mbouyer/canbus_solar_mppt/hardware/CAD/decoupe-couvercle.dxf

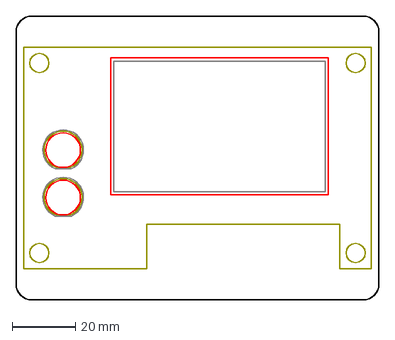
[picture p1: CAD file, 2023-04-26]
hardware/CAD/decoupe-couvercle.dxf
114.7 x 89.7 mm
