mbouyer/canbus_solar_mppt/hardware/CAD/pcb-stack.dxf

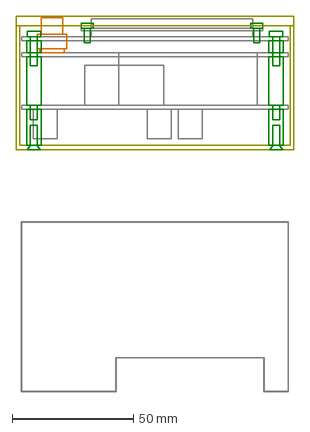
[picture p2: CAD file, 2023-01-29]
hardware/CAD/pcb-stack.dxf
114.7 x 154.9 mm
