mbouyer/canbus_solar_mppt/hardware/CAD/control-Edge_Cuts.dxf

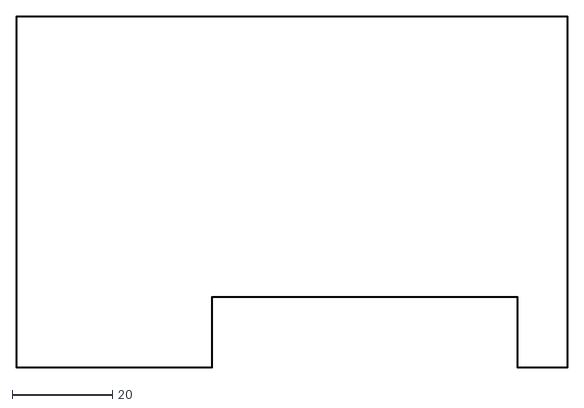
[picture p3: CAD file, 2023-01-26]
hardware/CAD/control-Edge_Cuts.dxf
110.1 x 70.1
