mbouyer/canbus_solar_mppt/software/pic18_mppt/i2c.c

/*
 * Copyright (c) 2022 Manuel Bouyer
 *
 * All rights reserved.
 *
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
 * THIS SOFTWARE IS PROVIDED BY THE NETBSD FOUNDATION, INC. AND CONTRIBUTORS
 * ``AS IS'' AND ANY EXPRESS OR IMPLIED WARRANTIES, INCLUDING, BUT NOT LIMITED
 * TO, THE IMPLIED WARRANTIES OF MERCHANTABILITY AND FITNESS FOR A PARTICULAR
 * PURPOSE ARE DISCLAIMED.  IN NO EVENT SHALL THE FOUNDATION OR CONTRIBUTORS
 * BE LIABLE FOR ANY DIRECT, INDIRECT, INCIDENTAL, SPECIAL, EXEMPLARY, OR
 * CONSEQUENTIAL DAMAGES (INCLUDING, BUT NOT LIMITED TO, PROCUREMENT OF
 * SUBSTITUTE GOODS OR SERVICES; LOSS OF USE, DATA, OR PROFITS; OR BUSINESS
 * INTERRUPTION) HOWEVER CAUSED AND ON ANY THEORY OF LIABILITY, WHETHER IN
 * CONTRACT, STRICT LIABILITY, OR TORT (INCLUDING NEGLIGENCE OR OTHERWISE)
 * ARISING IN ANY WAY OUT OF THE USE OF THIS SOFTWARE, EVEN IF ADVISED OF THE
 * POSSIBILITY OF SUCH DAMAGE.
 */

#include <xc.h>
#include <stdio.h>
#include <stdlib.h>
#include <i2c.h>

#if 1
#define DPRINTF(x) printf x
#else
#define DPRINTF(x) /**/
#endif

typedef volatile enum {
	I2C_IDLE = 0,
	I2C_TX,
	I2C_RX_TXREG,
	I2C_RX,
	I2C_TXDMA,
	I2C_RXDMA,
} i2c_status_t;

static i2c_status_t i2c_status;
static i2c_return_t *i2c_return;
static uint8_t i2c_address;
static uint8_t *i2c_data;
static uint8_t i2c_size;
static __bit i2c_swap;

static void i2c_printstatus(void);

#define I2C_IRQDIS \
	{ \
		I2C1ERRbits.NACKIE = 0; \
		I2C1PIEbits.CNTIE = 0; \
		PIE7bits.I2C1TXIE = 0; \
		PIE7bits.I2C1RXIE = 0; \
		PIE7bits.I2C1IE = 0; \
		PIE7bits.I2C1EIE = 0; \
	}

#define I2C_IRQEN \
	{ \
		I2C1ERRbits.NACKIE = 1; \
		I2C1PIEbits.CNTIE = 1; \
		PIE7bits.I2C1IE = 1; \
		PIE7bits.I2C1EIE = 1; \
	}

#define I2C_WAIT_TX { \
	int i2c_wait_count = 0; \
	while (!I2C1STAT1bits.TXBE) { \
		i2c_wait_count++; \
		if (i2c_wait_count == 30000) { \
			printf("I2C@%d TX timeout\n", (int)address); \
			i2c_printstatus(); \
			i2c_wait_idle(); \
			*r = I2C_ERROR; \
			return; \
		} \
	} \
    }

static inline uint8_t
i2c_wait_idle(void)
{
	int i2c_wait_count = 0;
	uint8_t tries = 0;
	while (I2C1STAT0bits.MMA) {
		i2c_wait_count++;
		if (i2c_wait_count == 10000) {
			if (tries > 0 || I2C1CON1bits.P) {
				printf(("I2C idle timeout\n"));
				i2c_printstatus();
				return 0;
			}
			I2C1CON1bits.P = 1;
			tries++;
			i2c_wait_count = 0;
		}
	}
	return 1;
}

static void
i2c_readreg_s(const uint8_t address, uint8_t reg, uint8_t *data, uint8_t size, uint8_t swap, i2c_return_t *r)
{
	*data = 0;
	uint8_t i;
	uint16_t i2c_wait_count;
	int retry_count = 5;

again:
	if (retry_count-- == 0) {
		printf("i2c read: retry == 0 ");
		i2c_printstatus();
		*r= I2C_ERROR;
		return;
	}
	if (i2c_wait_idle() == 0) {
		*r= I2C_ERROR;
		return;
	}
	*r= I2C_INPROGRESS;

	I2C1STAT1bits.CLRBF = 1;
	I2C1STAT1 = 0;
	I2C1PIR = 0;
	I2C1ERR = 0;

	/* send register address */
	I2C1CON0bits.RSEN = 1;
	I2C1CON1bits.ACKDT = 0;
	I2C1CON1bits.ACKCNT = 0;
	I2C1ADB1 = address;
	I2C1CNTH = 0;
	I2C1CNTL = 1;
	I2C1TXB = reg;
	I2C1CON0bits.S = 1;
	i2c_status = I2C_RX_TXREG;

	if (swap) {
		i2c_data = &data[size - 1];
		i2c_swap = 1;
	} else {
		i2c_data = &data[0];
		i2c_swap = 0;
	}
	i2c_address = address;
	i2c_size = size;
	i2c_return = r;

	I2C_IRQEN;

	return;
#if 0


	I2C_WAIT_TX;

	while (!I2C1CON0bits.MDR) {
		;
	}
	if (I2C1ERRbits.NACKIF) {
		printf("i2c_read NACK\n");
		goto again;
	}
	/* read bytes */
	I2C1PIR = 0;
	I2C1ERR = 0;
	I2C1CON0bits.RSEN = 0;
	I2C1CON1bits.ACKCNT = 1;
	I2C1CON1bits.ACKDT = 0;
	I2C1ADB1 = address | 1;
	I2C1CNTH = 0;
	I2C1CNTL = size;
	I2C1CON0bits.S = 1;
	if (swap) {
		i2c_data = &data[size - 1];
		i2c_swap = 1;
	} else {
		i2c_data = &data[0];
		i2c_swap = 0;
	}
	i2c_status = I2C_RX;
	i2c_return = r;
	I2C_IRQEN;
	PIE7bits.I2C1RXIE = 1;
#endif

#if 0
	for (i = size ; i != 0; i--) {
		for (i2c_wait_count = 10000; i2c_wait_count > 0; i2c_wait_count--) {
			if (I2C1STAT1bits.RXBF)
				break;
		}
		if (i2c_wait_count == 0) {
			printf("I2C RX timeout: ");
			i2c_printstatus();
			I2C1STAT1 = 0;
			I2C1ERR = 0;
			goto again;
		}
		if (swap) {
			data[i - 1] = I2C1RXB;
		} else {
			data[size - i] = I2C1RXB;
		}
	}
	*r= I2C_COMPLETE;
#endif
}

void
i2c_readreg(const uint8_t address, uint8_t reg, uint8_t *data, uint8_t size,
    i2c_return_t *r) {
	i2c_readreg_s(address, reg, data, size, 0, r);
}

void
i2c_readreg_be(const uint8_t address, uint8_t reg, uint8_t *data, uint8_t size,
    i2c_return_t *r) {
	return i2c_readreg_s(address, reg, data, size, 1, r);
}

static void
i2c_writereg_s(const uint8_t address, uint8_t reg, uint8_t *data, uint8_t size,
    uint8_t swap, i2c_return_t *r)
{
	uint8_t i;


	if (i2c_wait_idle() == 0) {
		*r = I2C_ERROR;
		return;
	}

	*r = I2C_INPROGRESS;
	i2c_address = address;

	I2C1STAT1bits.CLRBF = 1;
	I2C1STAT1 = 0;
	I2C1PIR = 0;
	I2C1ERR = 0;

	/* send register address */
	I2C1CON0bits.RSEN = 0;
	I2C1CON1bits.ACKDT = 0;
	I2C1CON1bits.ACKCNT = 1;
	I2C1ADB1 = address;
	I2C1CNTH = 0;
	I2C1CNTL = size + 1;
	I2C1TXB = reg;
	I2C1CON0bits.S = 1;
	if (swap) {
		i2c_data = &data[size - 1];
		i2c_swap = 1;
	} else {
		i2c_data = &data[0];
		i2c_swap = 0;
	}
	i2c_status = I2C_TX;
	i2c_return = r;
	I2C_IRQEN;
	PIE7bits.I2C1TXIE = 1;
}

void
i2c_writereg(const uint8_t address, uint8_t reg, uint8_t *data, uint8_t size,
    i2c_return_t *r)
{
	i2c_writereg_s(address, reg, data, size, 0, r);
}

void
i2c_writereg_be(const uint8_t address, uint8_t reg, uint8_t *data, uint8_t size,
    i2c_return_t *r)
{
	i2c_writereg_s(address, reg, data, size, 1, r);
}

void
i2c_writecmd(const uint8_t address, uint8_t reg, i2c_return_t *r)
{
	i2c_writereg(address, reg, NULL, 0, r);
}                                     

void
i2c_writereg_dma(const uint8_t address, uint8_t reg, uint8_t *data,
    uint16_t size, i2c_return_t *r)
{
	uint8_t i;

	if (i2c_wait_idle() == 0) {
		*r = I2C_ERROR;
		return;
	}

	*r = I2C_INPROGRESS;
	i2c_address = address;
	I2C1STAT1bits.CLRBF = 1;
	I2C1STAT1 = 0;
	I2C1PIR = 0;
	I2C1ERR = 0;
	PIR2 &= 0x0f;

	/* send register address */
	I2C1CON0bits.RSEN = 0;
	I2C1CON1bits.ACKDT = 0;
	I2C1CON1bits.ACKCNT = 1;
	I2C1ADB1 = address;
	I2C1CNTH = (size + 1) >> 8;
	I2C1CNTL = (size + 1) & 0xff;
	I2C1TXB = reg;
	I2C1CON0bits.S = 1;
	/* setup DMA1 */
	DMASELECT = 0;
	DMAnCON0 = 0;
	DMAnCON1 = 0x03; /* SSTP, source increment, source from RAM */
	DMAnSSAL = ((uint16_t)data) & 0xff;
	DMAnSSAH = ((uint16_t)data) >> 8;
	DMAnSSAU = 0;
	DMAnSSZH = (size >> 8);
	DMAnSSZL = size & 0xff;
	DMAnDSA = &I2C1TXB;
	DMAnDSZL = 1;
	DMAnDSZH = 0;
	DMAnSIRQ = 0x39; /* I2C1TX */
	DMAnAIRQ = 0x3b; /* I2C1E */
	DMAnAIRQ = 0;

	DMAnCON0 = 0xc4; /* enable, hardware IRQ trigger/abort */

	i2c_status = I2C_TXDMA;
	i2c_return = r;
	I2C_IRQEN;

#if 0
	i = i2c_wait(i2c_return);
	if (*i2c_return != I2C_COMPLETE || PIR2bits.DMA1AIF) {
		printf(" %d I2C@%d TX DMA timeout\n", *r, (int)address);
		printf("SCNT %d CON0 0x%x PIR2 0x%x\n", (int)DMAnSCNT, (int)DMAnCON0, (int)PIR2);
		i2c_printstatus();
	}
#endif
	return;
}

void __interrupt(__irq(I2C1TX), __low_priority, base(IVECT_BASE))
irql_i2c1tx(void)
{
	I2C1TXB = *i2c_data;
	if (i2c_swap)
		i2c_data--;
	else
		i2c_data++;
}

void __interrupt(__irq(I2C1RX), __low_priority, base(IVECT_BASE))
irql_i2c1rx(void)
{
	*i2c_data = I2C1RXB;
	if (i2c_swap)
		i2c_data--;
	else
		i2c_data++;
}

void __interrupt(__irq(I2C1), __low_priority, base(IVECT_BASE))
irql_i2c1(void)
{
	if (I2C1PIRbits.CNTIF) {
		if (i2c_status == I2C_RX_TXREG) {
			if (!I2C1CON0bits.MDR) {
				I2C_IRQDIS;
				if (I2C1STAT0bits.MMA)
					I2C1CON1bits.P = 1;
				*i2c_return = I2C_ERROR;
				i2c_status = I2C_IDLE;
				return;
			}
			/* read bytes */
			I2C1PIR = 0;
			I2C1ERR = 0;
			I2C1CON0bits.RSEN = 0;
			I2C1CON1bits.ACKCNT = 1;
			I2C1CON1bits.ACKDT = 0;
			I2C1ADB1 = i2c_address | 1;
			I2C1CNTH = 0;
			I2C1CNTL = i2c_size;
			I2C1CON0bits.S = 1;
			i2c_status = I2C_RX;
			PIE7bits.I2C1RXIE = 1;
		} else {
			I2C_IRQDIS;
			*i2c_return = I2C_COMPLETE;
			i2c_status = I2C_IDLE;
		}
	}
}

void __interrupt(__irq(I2C1E), __low_priority, base(IVECT_BASE))
irql_i2c1error(void)
{
	if (I2C1ERRbits.NACKIF) {
		I2C_IRQDIS;
		if (I2C1STAT0bits.MMA)
			I2C1CON1bits.P = 1;
		*i2c_return = I2C_ERROR;
		i2c_status = I2C_IDLE;
	}
}

void
i2c_init(void)
{
	RC4I2C = 0x41; /* I2C fast slew-rate, no pull-up, i2c threshold */
	RC3I2C = 0x41; /* I2C fast slew-rate, no pull-up, i2c threshold */
	RC3PPS = 0x37; /* SCL */
	RC4PPS = 0x38; /* SDA */
	I2C1SCLPPS = 0x13; /* RC3 */
	I2C1SDAPPS = 0x14; /* RC4 */
	ODCONCbits.ODCC3 = 1;
	ODCONCbits.ODCC4 = 1;
	LATCbits.LATC3 = 1;
	LATCbits.LATC4 = 1;
	TRISCbits.TRISC3 = 0;
	TRISCbits.TRISC4 = 0;
	I2C1CON0 = 0x04; /* On, 7 bits I2C host mode */
	I2C1CON1 = 0;
	I2C1CON2 = 0x04; /* FME, address buffer enabled, 100ns SDA hold */
	I2C1CLK = 1; /* clock = fosc  (10000khz) */
	I2C1BAUD = 4; /* prescale = 5 -> clk = 500Khz */
	I2C1ERR = 0x01; /* enable NACK interrupt */
	I2C1CON0bits.EN = 1;

	i2c_status = I2C_IDLE;
}

void
i2c_abort()
{
	printf("I2C@%d abort %d\n", (int)i2c_address, i2c_status);
	i2c_printstatus();
	i2c_wait_idle();
	*i2c_return = I2C_ERROR;
}

static void
i2c_printstatus(void)
{
	printf("%d CON 0x%x 0x%x 0x%x", i2c_status, I2C1CON0, I2C1CON1, I2C1CON2);
	printf("  STAT 0x%x 0x%x PIR 0x%x", I2C1STAT0, I2C1STAT1, I2C1PIR);
	printf("  ERR 0x%x CNT 0x%x 0x%x\n", I2C1ERR, I2C1CNTH, I2C1CNTL);
}
