mbouyer/canbus_solar_mppt/(commit log)

2023-01-18 Work in progress: - copy pic18 + canbus from battery_monitor, as well as the voltage/current measure section - build the power supply circuit
    [canbus_solar_mppt.kicad_pcb, canbus_solar_mppt.kicad_sch, dc-dc.kicad_sch, logic_canbus.kicad_sch]
2023-01-18 Add feedthrough capacitors as EMI filters on power inputs
    [canbus_solar_mppt.kicad_sch, dc-dc.kicad_sch, logic_canbus.kicad_sch]
2023-01-19 WIP: complete DC/DC engine
    [canbus_solar_mppt.kicad_sch, dc-dc.kicad_sch]
2023-01-20 Add a voltage reference for the pic18 comparator, and a matching voltage divider at DC/DC output.
    [canbus_solar_mppt.kicad_sch, dc-dc.kicad_sch, logic_canbus.kicad_sch]
2023-01-20 Add more signals between pic18 and DC/DC
    [canbus_solar_mppt.kicad_sch, dc-dc.kicad_sch, logic_canbus.kicad_sch]
2023-01-20 Add MCOB12864JX oled display. I2C-connected, not enough pic18 pins for SPI ...
    [canbus_solar_mppt.kicad_sch, logic_canbus.kicad_sch]
2023-01-20 Add 2 control buttons (could be more).
    [canbus_solar_mppt.kicad_sch, logic_canbus.kicad_sch]
2023-01-20 Use a SMD thermistor
    [canbus_solar_mppt.kicad_sch, logic_canbus.kicad_sch]
2023-01-21 Add footprint for OLED display annotate schematic run and fix ERC
    [canbus_solar_mppt.kicad_sch, dc-dc.kicad_sch, logic_canbus.kicad_sch]
2023-01-21 Decrease pull gate resitors of P-MOS to decrease turn-off time. Maybe switch to a gate driver ic ?
    [canbus_solar_mppt.kicad_sch, dc-dc.kicad_sch]
2023-01-21 Fix up resistor footprints, use only SMD for now.
    [canbus_solar_mppt.kicad_sch, dc-dc.kicad_sch, logic_canbus.kicad_sch]
2023-01-21 Switch from BSS123 + GS resistor to DGD0215 mosfet driver.
    [canbus_solar_mppt.kicad_sch, dc-dc.kicad_sch, logic_canbus.kicad_sch]
2023-01-22 Change Pmos transistors for a reference with larger package. Ajust some other footprints.
    [canbus_solar_mppt.kicad_sch, dc-dc.kicad_sch]
2023-01-22 Really connect PAC1953 EP to GND
    [dc-dc.kicad_sch]
2023-01-22 Route de power part of the project
    [canbus_solar_mppt.kicad_pcb]
2023-01-22 Split project in 2 boards: the power DC/DC and associated instrumentation, and control (with pic18 and canbus)
    [canbus_solar_mppt.kicad_sch, control.kicad_pcb, control.kicad_sch, logic_canbus.kicad_sch, power-dcdc.kicad_pcb, power-dcdc.kicad_sch]
2023-01-22 Add board-to-board connectors.
    [power-dcdc.kicad_sch]
2023-01-22 Rsync PCB with schematic
    [power-dcdc.kicad_pcb]
2023-01-22 Finish routing the power board
    [power-dcdc.kicad_pcb, power-dcdc.kicad_sch]
2023-01-22 Make sure to remove isolated ground planes. Add more GND vias.
    [power-dcdc.kicad_pcb]
2023-01-23 Move thermistor to power-dcdc board (measure board temp) Adjust power-dcdc board layout, pass DRC
    [control.kicad_sch, power-dcdc.kicad_pcb, power-dcdc.kicad_sch]
2023-01-23 Add board-to-board connectors in control schematic
    [control.kicad_sch]
2023-01-23 Place holes and connectors on control board to match DC/DC
    [control.kicad_pcb]
2023-01-23 Make power tracks larger
    [power-dcdc.kicad_pcb]
2023-01-23 Route control board. Will need a separate board for display.
    [control.kicad_pcb, control.kicad_sch]
2023-01-24 Re-route PCBs to move RJ45 connectors on bottom, saving a bit of stack size.
    [control.kicad_pcb, control.kicad_sch, power-dcdc.kicad_pcb, power-dcdc.kicad_sch]
2023-01-25 Adjust PWM resistor divider to better match NCP5091B mid-state input voltage.
    [control.kicad_pcb, control.kicad_sch]
2023-01-25 WIP on diaplay PCB.
    [control.kicad_sch, display.kicad_pcb, display.kicad_sch]
2023-01-25 Route display PCB. Adjust control for connector wiring changes.
    [control.kicad_pcb, control.kicad_sch, display.kicad_pcb, display.kicad_sch]
2023-01-25 Finish routing control board
    [control.kicad_pcb]
2023-01-25 Cleanup trace & via of display board
    [display.kicad_pcb]
2023-01-25 optimise some more control board
    [control.kicad_pcb]
2023-01-25 optimise a bit power board
    [power-dcdc.kicad_pcb]
2023-01-26 Add PCB stack drawing
    [control-Edge_Cuts.dxf, pcb-stack.dxf]
2023-01-27 normalise and update P/N, update footprint to match
    [control.kicad_sch, display.kicad_sch, power-dcdc.kicad_sch]
2023-01-27 Adjust PCBs after reference and footprint changes
    [control.kicad_pcb, display.kicad_pcb, power-dcdc.kicad_pcb]
2023-01-27 Adjust track near connector
    [control.kicad_pcb]
2023-01-27 Route unused RA5 to display and power board connectors, "just in case"
    [control.kicad_pcb, control.kicad_sch]
2023-01-28 pcb-stack.dxf: add more details
    [pcb-stack.dxf]
2023-01-28 power-dcdc: move power connectors closer to edge, the connectors used are actually a bit smaller than footprint
    [power-dcdc.kicad_pcb]
2023-01-28 control: view the inductance from dcdc
    [control.kicad_pcb]
2023-01-29 Adjust for "0 height" display nuts
    [control.kicad_pcb, display.kicad_pcb]
2023-01-29 pcb-stack: add more defatils
    [pcb-stack.dxf]
2023-01-29 One more cosmetic track adjust
    [control.kicad_pcb]
2023-01-29 On second though, the pac1953 won't be fast enough for the PWM regulation loop. So add a resistor divider routed to RA5 to get the solar voltage from the PIC18's ADC.
    [control.kicad_pcb, control.kicad_sch, power-dcdc.kicad_pcb, power-dcdc.kicad_sch]
2023-01-29 Re-annotate schematics
    [control.kicad_pcb, control.kicad_sch, power-dcdc.kicad_pcb, power-dcdc.kicad_sch]
2023-01-29 Connect mounting holes to GND
    [control.kicad_pcb, control.kicad_sch, display.kicad_pcb, display.kicad_sch, power-dcdc.kicad_pcb, power-dcdc.kicad_sch]
2023-01-29 Change some resistor values to match available ones.
    [control.kicad_pcb, control.kicad_sch, power-dcdc.kicad_pcb, power-dcdc.kicad_sch]
2023-01-29 Final pass on part numbers
    [control.kicad_sch, display.kicad_sch, power-dcdc.kicad_sch]
2023-01-29 One more P/N update
    [power-dcdc.kicad_sch]
2023-02-03 Add a pulldown resistor to /RST_DISP
    [display.kicad_pcb, display.kicad_sch]
2023-02-12 one more track cleanup
    [power-dcdc.kicad_pcb]
2023-02-12 power-dcdc: increase clearance where possible; cleanup tracks
    [power-dcdc.kicad_pcb]
2023-02-12 power-dcdc: more track adjusteemnts
    [power-dcdc.kicad_pcb]
2023-02-12 control: rework tracks, increase clearance where possible.
    [control.kicad_pcb]
2023-02-12 *: connect unused connectors pins to GND
    [control.kicad_pcb, control.kicad_sch, display.kicad_pcb, display.kicad_sch, power-dcdc.kicad_pcb, power-dcdc.kicad_sch]
2023-02-22 Increase clearance once again
    [control.kicad_pcb, display.kicad_pcb, power-dcdc.kicad_pcb]
2023-03-01 Add some copper around J3's holes, so that they will get isolated
    [control.kicad_pcb]
2023-03-01 Add fabrication files
    [power-dcdc.kicad_pcb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]
2023-03-01 Add fab files for display
    [display.kicad_pcb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]
2023-03-03 regen fab files
    [control-B_Cu.gbr, control-F_Cu.gbr]
2023-03-06 Add solder mask/paste files
2023-03-12 Start writing pic18 software. Based on the battery_monitor soft.
2023-03-12 More efficient OLED_CTRL process: write multiple command bytes in one i2c transaction.
2023-03-12 Increase i2c frequency to 200Khz. Although the display works at 400Khz, it seems that the pac1953 works only up to 266Khz. To be investigated.
2023-03-12 implement DMA-based i2c writes. Still doing busy-wait for now ...
2023-03-12 Prefer extosc for i2c clock source.
2023-03-12 Use i2c errors to abort DMA1.
    [i2c.c]
2023-03-12 Add fonts from the canbus_autopilot project. Finally print a string on the oled
2023-03-13 i2c: be more robust against NACK on address byte.
2023-03-13 i2c: update API for upcoming interrupt mode.
2023-03-13 i2c: Use interrupts for write and write_dma
2023-03-15 Implement buttons: use comparator to get interrupts and ADC to get the button's value. Start using ADC contexts
2023-03-25 Tests have shown that the DGD0215 behavior when driven while not powered is quite bad: not only the drive voltage is forwarded to its Vcc pin (this is expexted), but when the voltage rises on Vcc thi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
    [power-dcdc.kicad_sch]
2023-03-25 power-dcdc: testings have shown that the NCP5901 zero cross detection trips way too early, leaving most of the low side current trough the body diode of the mosfet. It starts working properly at 3A. 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
    [power-dcdc.kicad_sch]
2023-03-25 Re-anotate schematic (from scratch)
    [power-dcdc.kicad_sch]
2023-03-26 Switch to a 60V N-channel mosfet on input, to have some margin.
    [power-dcdc.kicad_sch]
2023-03-26 Provision for a second bootstrap capacitor
    [power-dcdc.kicad_sch]
2023-03-26 On second through use a 1µF capacitor for bootstrap
    [power-dcdc.kicad_sch]
2023-03-26 Provision components to limit ringing on the sw node: A Rboot resistor and a R/C filter on the sw node.
    [power-dcdc.kicad_sch]
2023-03-26 Add a SMBJ16 on output of the dc/dc converter, usefull if the output mosfets are all off.
    [power-dcdc.kicad_sch]
2023-03-26 Make it clear that some components are not known yet.
    [power-dcdc.kicad_sch]
2023-03-26 Provision a schottky diode in parallel with Rboost
    [power-dcdc.kicad_sch]
2023-03-26 Annontate schematic again
    [power-dcdc.kicad_sch]
2023-03-26 Import schematic changes to PCB; re-route the output path.
    [power-dcdc.kicad_pcb]
2023-03-26 PCB: Add the TVS diode at the output of the DC/DC
    [power-dcdc.kicad_pcb]
2023-03-26 dcdc PCB: work in progress on switch node. Needs to move input capacitor to the right side of the solar power track; current loop through mosfets is way too long as it is !
    [power-dcdc.kicad_pcb]
2023-03-27 Finish re-implementing the SW node. Enlarge ground vias.
    [power-dcdc.kicad_pcb]
2023-03-27 Protect NCP5901 SW entry with a SMBJ28
    [power-dcdc.kicad_pcb, power-dcdc.kicad_sch]
2023-03-27 Cleanup tracks & via; run DRC
    [power-dcdc.kicad_pcb]
2023-03-27 Forgot to save schematic from previous
    [power-dcdc.kicad_sch]
2023-03-28 remplace lp4951 with the pin-compatible, more resistant mic2951. Add a 1µF at the input of the mic2951.
    [power-dcdc.kicad_pcb, power-dcdc.kicad_sch]
2023-03-28 Re-route around DCDC-PWM connector to get SOLAR_PWR from a place less subject to spikes
    [power-dcdc.kicad_pcb, power-dcdc.kicad_sch]
2023-03-28 Enlarge via holes from 0.6 to 0.7 (rivets don't fit in 0.6)
    [power-dcdc.kicad_pcb]
2023-03-28 Minor layout adjustements
    [power-dcdc.kicad_pcb]
2023-03-28 More minor adjustements
    [power-dcdc.kicad_pcb]
2023-03-28 Move PWM_OFF away from the strongest inductive (the SW node)
    [power-dcdc.kicad_pcb]
2023-03-28 Misc small cleanups
    [power-dcdc.kicad_pcb]
2023-03-28 Bump outer size of small vias to 1.7 to respect DRC. Run cleanup net & via and DRC.
    [power-dcdc.kicad_pcb]
2023-03-30 Fab files for dcdc V2
    [power-dcdc.kicad_pcb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]
2023-04-01 Fix convertion of xbm to our per-column format
    [icons16x16.c, xbm2font.c]
2023-04-01 Avoid race in button handling; process down event only when in idle state, report up even only once down event has been handled
    [main.c]
2023-04-01 No need to wait for address to be accepted before starting DMA
2023-04-01 i2c: use interrupts for read
2023-04-01 Make I2C_DATABUFSZ 256 bytes (2 full lines) and switch i2c_writereg_dma()'s len parameter to uint16_t
2023-04-01 Make OLED i2c operations event-driven
2023-04-02 Make i2c_read use interrupt for the reg write to data read transistion. Introduce i2c_abort(), to be used when a i2c transaction has to be stopped (e.g. timeout).
2023-04-02 Insert a blank column between characters for font 5x8 (making it really 6x8)
2023-04-02 Add and use shortcuts for unsigned {char,int,long}
    [main.c]
2023-04-02 Make PAC i2c operations event-driven
2023-04-02 Deal with i2c_return in *_i2c_exec()
2023-04-02 schedule i2c bus access in the main loop, giving priority to the PAC
2023-04-02 Fix bit ordering of pac_ctrl_t Was working because all important bits were 0
    [pac195x.h]
2023-04-02 Add a COMPLETE state to i2c state machine, to let users have a chance to known when a command has completed. Start periodic reading of PAC1953 values
2023-04-02 Fix pac_neg_pwr_fsr_t field order.
    [pac195x.h]
2023-04-02 switch voltages to PAC_PWRSFR_UFSR, so we can get values up to 32V
2023-04-07 Power: remove the DGD0215, they are still problematic (the Pmos are briefly on while power up, and can eventually stay on). Instead drive the Pmos gates directly from the BSS123, at the price of a lo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
    [power-dcdc.kicad_sch]
2023-04-13 Work in progress on driving BATT1/BATT2. Not there yet; the CLC seems OK but in looks like RB4/RB5 are stuck to some alternate function. Avoid undefined behavior when OLED is in error. Others minor c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
    [main.c]
2023-04-15 Implement reading the 4 ADC channels.
2023-04-16 Switch to CM2 for buttons interrupts; use CM1 for PVM_V monitoring.
2023-04-16 WIP on the PWM
2023-04-16 Remove SLEEP() from the main loop; it doens't affect power much, and makes short waits easier.
    [main.c]
2023-04-16 PWM is working, with static values for now
2023-04-16 Make error handling (PWM_OK down, PWM_OK timeout, PWM_V too high) work.
    [main.c]
2023-04-18 Implement PWM computation from duty cycle. Allow to ramp up duty cycle, to avoid PWM error at startup.
    [main.c]
2023-04-18 record batteries current with the correct sign
    [main.c]
2023-04-18 Introduce a chrg_fsm to drive the PWM
2023-04-18 Increase TU16A rate to 100hz. try to read the PAC average registers every 10ms. Update display at 5hz.
2023-04-19 Use raw current values for MPPT computations, and average on 4 samples. One-bit error from measure to measure would lead to large jumps of the duty cycle.
    [main.c]
2023-04-19 Add resistors on pic18 pads connected to DCDC-PWM connector; to protect from spike and accidental short-circuits with solar_power.
    [control.kicad_pcb, control.kicad_sch]
2023-04-20 On second though use 4K7 resistors on PIC18 I/O instead of 1K Update fabrication files.
    [control.kicad_pcb, control.kicad_sch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]
2023-04-20 Try to move faster when we're far away from the MP point. Implement constant voltage mode.
2023-04-20 Switch faster between CV and MPPT modes if the difference between bvolt and target is more than 0.5v
2023-04-22 Cleanup time handling; introduce a time_events bit structure which is reset on each loop. Makes it easier to handle time events in subroutines of main loop.
    [main.c]
2023-04-23 Implement main display page with large characters. Move actual display to debug page. Implement page switching.
2023-04-24 Ajust solder mask by -0.075mm for our fabrication process.
    [control.kicad_pcb]
2023-04-26 Add cover drawing, for machining buttons & display holes
    [decoupe-couvercle.dxf]
2023-04-26 With the updated control board, the transition from temnp to pwm_v on the ADC channel can discharge the ADC capacitor through the added 4.7k resistor and generate a spike which triggers the comparato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
    [main.c]
2023-04-28 Rework charger rampup&mppt: use the rampup results to locate the MP point.
    [main.c]
2023-04-28 In case of pwm error, wait one second and restart
    [main.c]
2023-04-28 check temperature once per second, and implement PWME_OVERTEMP error state. Temperature limit 70degC, restart at 60degC
    [main.c]
2023-04-28 Fix integer overflow in previous
    [main.c]
2023-04-28 WIP on battery scheduling: move some CHRG parameters to batt_context_t
2023-04-28 Mark batteries with more than 8V as active
2023-04-28 Fix mistake in _read_voltcur[] access. While there fix some numering mistakes in comments
    [main.c]
2023-04-28 Implement battery switching in the CHRG FSM.
2023-04-29 Stop CHRG (and so turn off batteries) when the current through the active battery goes backward. This avoids current going back to solar power rail, with the charger staying on.
    [main.c]
2023-04-29 CHRG_BSWITCH: if we didn't switch batteries go back to previous state
    [main.c]
2023-04-29 Implement basic battery scheduling: - record in battery context the time at which the battery became active - when switching to a battery in CV mode, ignore mode change for the 4 first PAC values, to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
2023-04-29 RAMPUP: check battery voltage only if bvalues_updated is true
2023-04-29 Autostart charger when conditions are good. Remove debug handling from buttons
2023-04-29 Average values over 1s using a sliding buffer for display. This gives more stable values with battery scheduling
2023-04-29 Improve recovery when one batterie dissapear: - reset battery states on negative battery current - increase error recovery time to 2s - don't check batterie presence while the PWM is in error state (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
    [main.c]
2023-04-30 Rework battery states: Remove CC, CV and CV_FLOAT and add BATTS_STANDBY, BATTS_BULK and BATTS_FLOAT. standby if for when we start with the voltage above 80% SOC, we consider there's no need to charge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
    Add batt_params_t to store various voltage states
    factor out some state checks in functions
    Decrease some timings so they have a chance to work with battery scheduling
    On negative current, reset state of active battery only.
    [main.c]
2023-04-30 Display batteries state in debug page Remove printf() in battery switch.
2023-04-30 Use local variable to avoid repetitive batt_v[] / 10
    [main.c]
2023-04-30 battstat2buf_*: don't print intensity if battery is not charging
2023-04-30 Add a details display page, with N2K addr, board temperature and battery status
2023-04-30 battstat2buf_*: work around a bug with sprintf("%2.1f") in a better way. One decimal for temperature is enough
    [main.c]
2023-04-30 Add some smoothing to temperature output from adc.
2023-04-30 Rerun a rampup for a battery if: - there has been 10mn since the last rampup - the duty cycle changed more than 10% - the current changed more than 10%
2023-04-30 Increase delay before checking if rampup is needed to 4s. Some cosmetic in printf
2023-05-01 Implement short/long press for buttons Implement this for battery status change. Make sure a the changer is turned off is all batteries are in standby state.
    [main.c]
2023-05-01 Increase negative_current_count to 10, seembs to be needed in some case.
2023-05-01 Centralise charger start/restart in schedule_batt_switch(). Call it when pacavg_rdy instead of 100hz, should be close to be 100hz and we're sure to have up to date battery measures Don't reset batter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
    [main.c]
2023-05-02 Make sure to start RAMPUP from the low value of the range: add a CHRG_RERAMPUP state which sets the initial pwm_duty_c, and change all CHRG_RAMPUP switch to CHRG_RERAMPUP. Start at 20%, with 10% the 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
    [main.c]
2023-05-02 increase negative_current_count faster if current is in the wrong direction by more than 20mA.
    [main.c]
2023-05-02 Wait 4ms before checking for rerampup after a switch.
2023-05-02 On second through we can wait 20ms after battery switch before checking for a re-rampup, as batt is on for at last 100ms
2023-05-03 Rework schedule_batt_switch(): add bc_sw_duration to battery context, which is the computed on time for this battery. Redo computation only once all active batteries have been scheduled.
    [main.c]
2023-05-04 Improve averaging of values for display: Decrease BATT_A_NCOUNT to 4 for better responsiveness. Bump batt_*_s[] size so that we're sure it's big enough, and it's a power of 2. Compute the number of s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
2023-05-08 If the battery voltage is high enough at startup, put the battery in FLOAT state instead of STANDBY.
2023-05-15 Properly initialise battctx[] in more cases so that the charger will start.
2023-05-17 Add a version string and build date. print version and build date in startup screen
2023-05-20 If batt current is negative, go to error if more than 40mA, and turn off batteries immediately if PWME_BATTCUR.
    [main.c]
2023-06-13 Add spice models (in kicad) for solar pannel and the power stage.
    [power-spice.kicad_sch, solar-spice.kicad_sch, solarpv.kicad_sch]
2023-06-15 Add simulation of output stage (to evaluate max trascient current when charing the output capacitor from the battery)
    [power-spice-out.kicad_sch]
2023-06-15 More accurate simulation with a BSS123 model and the 10k resistance from the control circuit. Doesn't change the peak transient current ...
    [power-spice-out.kicad_sch]
2023-06-15 Correct "shunt+cables" resistor value (shunt is 2mO, not 20mO)
    [power-spice-out.kicad_sch]
2023-06-15 Bump R3 from 1k to 4.7k. This décreases the inrush current from about 200A to 130. The Vgs is decreased by about 3V (from 12 to 9) which shouldn't affect much the Rsdon of the Si7149.
    [power-spice-out.kicad_sch]
2023-06-15 Add PWM_V RC network to the simulation model.
    [power-spice.kicad_sch]
2023-06-16 precharge the output capacitor before enabling battery when starting charger. Hopefully avoids large negative current spikes at startup.
    [main.c]
2023-06-16 Fix ad_pwm comptation (ADC is 12 bits, not 11)
    [main.c]
2023-06-16 Relax constraints on negative current abort
2023-07-02 printf() battery status every 10s. Support N2K_PRINTF
2023-07-06 Add ouput stage to power-spice simulator.
    [power-spice.kicad_sch]
2023-08-05 printf some data on pwm error.
    [main.c]
2023-08-05 Bump bulk voltage limit to 12.8V
2023-08-05 Implement tail current limit, to switch a battery from BULK to FLOAT
2023-08-08 switch to float: don't switch on transient negative current
2023-08-08 Don't error on overvoltage in some transcient cases
    [main.c]
2023-08-10 Avoid non-printable character
2023-08-10 Add a grace time for negative current on bswitch
2023-08-10 Always disable comparator when setting grace voltage time. Clear C1IF before enabling C1IE
2024-07-26 Add a new battery state: disable, forced by user. Back to operation only by user or reboot. Switch a battery to standby if the float current is below 40mA, and the other one wants more. Switch back t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
    [main.c]
2024-07-30 Redo a rampup if the input voltage rises by more than 2V
2025-03-13 Update for newer kicad version
    [control.kicad_sch]
2025-03-13 Fix swapped signal names
    [control.kicad_pcb, control.kicad_sch]
2025-03-14 power-dcdc: update for new kicad
    [power-dcdc.kicad_pcb, power-dcdc.kicad_sch]
